fsanzeni/Body-Moulded-Haptic-Compass/3D Modelling/Tests/Combined v1.obj

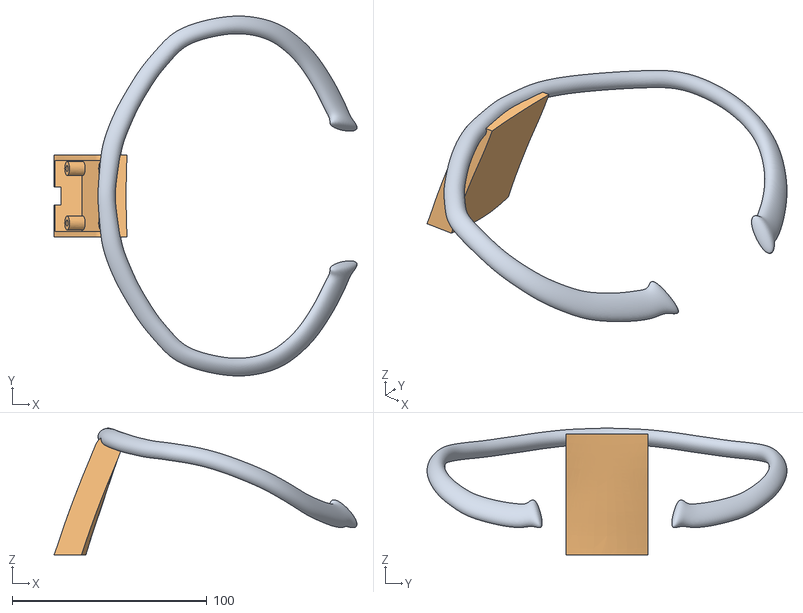
[picture p2: CAD file, 2023-04-23]
3D Modelling/Tests/Combined v1.obj
155.6 x 184.9 x 65.1
