fsanzeni/Body-Moulded-Haptic-Compass/PCB Design/NanoBLE_Compass/NanoBLE_Compass.step

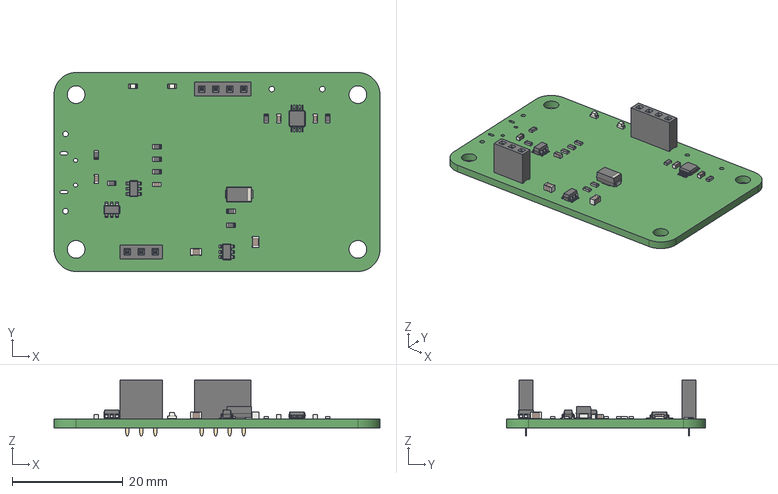
[picture p3: CAD file, 2023-04-23]
PCB Design/NanoBLE_Compass/NanoBLE_Compass.step
59.0 x 36.0 x 10.1 mm
