fsanzeni/Body-Moulded-Haptic-Compass/3D Modelling/Tests/Test_1 v1.stl

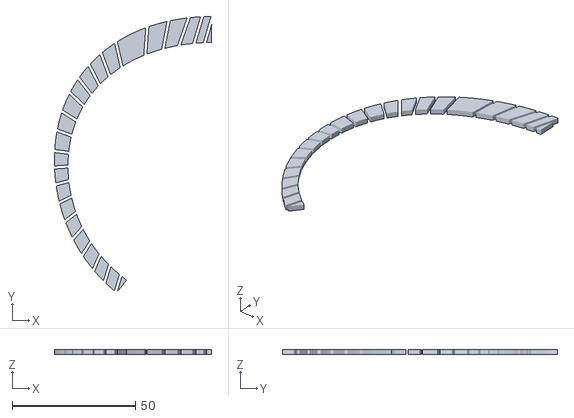
[picture p4: CAD file, 2023-04-23]
3D Modelling/Tests/Test_1 v1.stl
63.7 x 111.4 x 2.00
