fsanzeni/Body-Moulded-Haptic-Compass/3D Modelling/Tests/wearabletest.stl

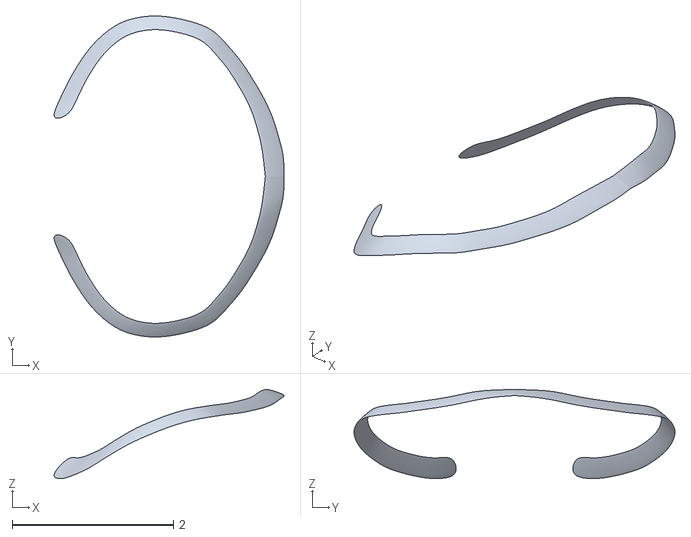
[picture p5: CAD file, 2023-04-23]
3D Modelling/Tests/wearabletest.stl
2.85 x 3.99 x 1.11
