fsanzeni/Body-Moulded-Haptic-Compass/Documentation/Calibration Values.txt

// Gyro
OFFSET MISSING

//Accel scale 16457.0
float B[3]
 {   -0.67,    0.11,   -0.01};

 float Ainv[3][3]
  {{  1.04251,  0.06266,  0.00031},
  {  0.06266,  0.98838, -0.02706},
  {  0.00031, -0.02706,  1.09352}};

// Magnetometer
//Mag scale 3746.0
 float B[3]
 {   24.50,   -2.05,  -47.08};

 float Ainv[3][3]
  {{  2.15592,  0.07699, -0.00474},
  {  0.07699,  2.16073, -0.01097},
  { -0.00474, -0.01097,  2.30156}};
