fsanzeni/Body-Moulded-Haptic-Compass/Documentation/Drift Measurements/raw_acc.xlsx

Time (ms) | Acc_X | Acc_Y | Acc_Z | Mag_X | Mag_Y | Mag_Z | Standard Deviation Acc | Standard Deviation Mag
0 | -0.77 | 0.44 | 1.15 | 40.99 | -18.32 | -54.25 | 0.6846524186 | 14.37910807
104 | 0.19 | 1.14 | -0.11 | 31.93 | -23.65 | -55.29
208 | -0.41 | 0.87 | -0.08 | 10.21 | -17.98 | -56.56
312 | -0.87 | -0.34 | -0.55 | 3.82 | -9.4 | -38.95
416 | -0.22 | -0.29 | -0.99 | 12.16 | 9.59 | -30.76
520 | 0.58 | 0.01 | -0.58 | 36.9 | 11.13 | -34.9
624 | 0.34 | 0.71 | 0.07 | 46.75 | -3.17 | -43.55
728 | -0.05 | -0.95 | 0.33 | 34.89 | 14.75 | -35.61
832 | -1.26 | -1.58 | -1.04 | 25.59 | -19.26 | -31.51
936 | -1.71 | 1.01 | -0.15 | 15.38 | -23.1 | -44.36
1040 | -0.81 | -0.84 | 0.57 | 1.71 | 1.43 | -55.04
1144 | 0.26 | -0.79 | -0.05 | 18.43 | 20.37 | -52.44
1248 | 0.92 | 0.51 | -0.61 | 44.17 | 10.35 | -44.25
1352 | 0.3 | 1.3 | -0.05 | 46.79 | -7.82 | -45.46
1456 | -0.63 | 0.52 | 1.34 | 43.47 | -6.35 | -58.92
1560 | -0.24 | 0.53 | 0.51 | 26.98 | -23.69 | -55.27
1664 | 0.3 | 1.26 | 0.66 | 17.76 | -13.7 | -64.98
1768 | 0.26 | 0.28 | 0.78 | 19.92 | -14.59 | -65.81
1872 | -0.2 | 1.17 | 0.83 | 17.82 | -7.36 | -70.39
1976 | 0.31 | 0.84 | 0 | 43.58 | -20.76 | -52.6
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
