fsanzeni/Body-Moulded-Haptic-Compass/PCB Design/NanoBLE_Compass/pcb.pdf

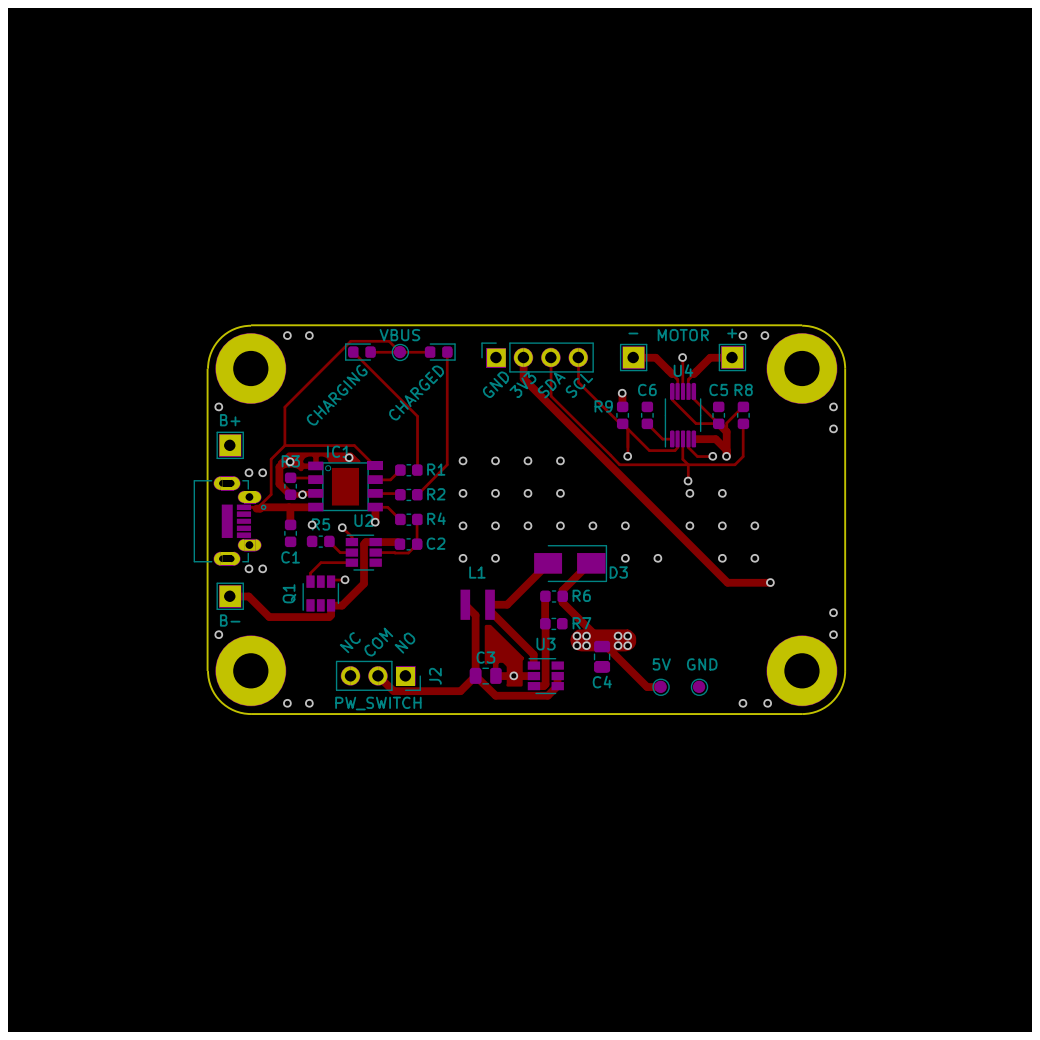
[picture p6: page 1]
