fsanzeni/Body-Moulded-Haptic-Compass/PCB Design/NanoBLE_Compass/pcb2.pdf

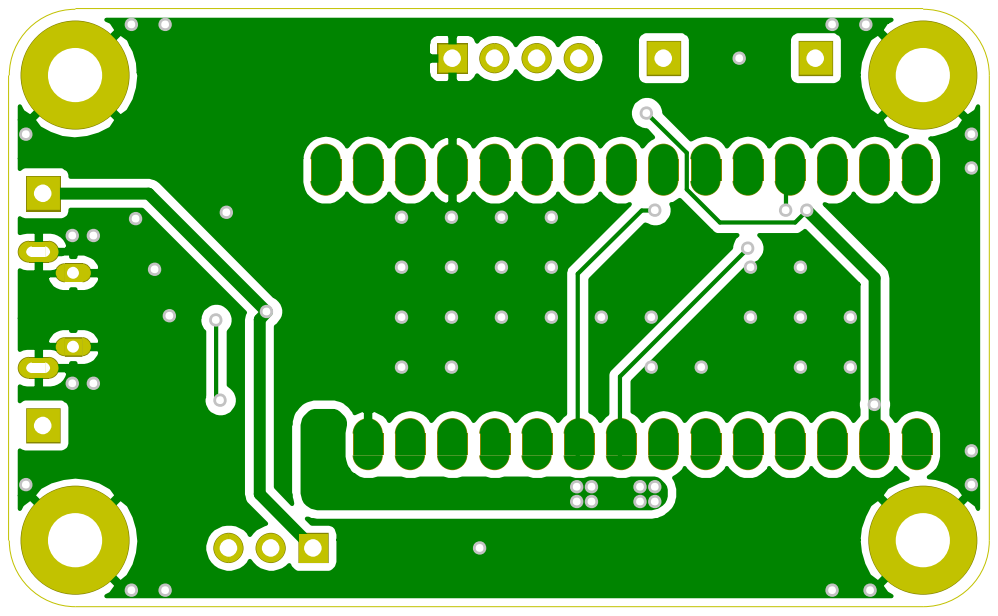
[picture p7: page 1]
