fsanzeni/Body-Moulded-Haptic-Compass/PCB Design/NanoBLE_Compass/schematic.pdf

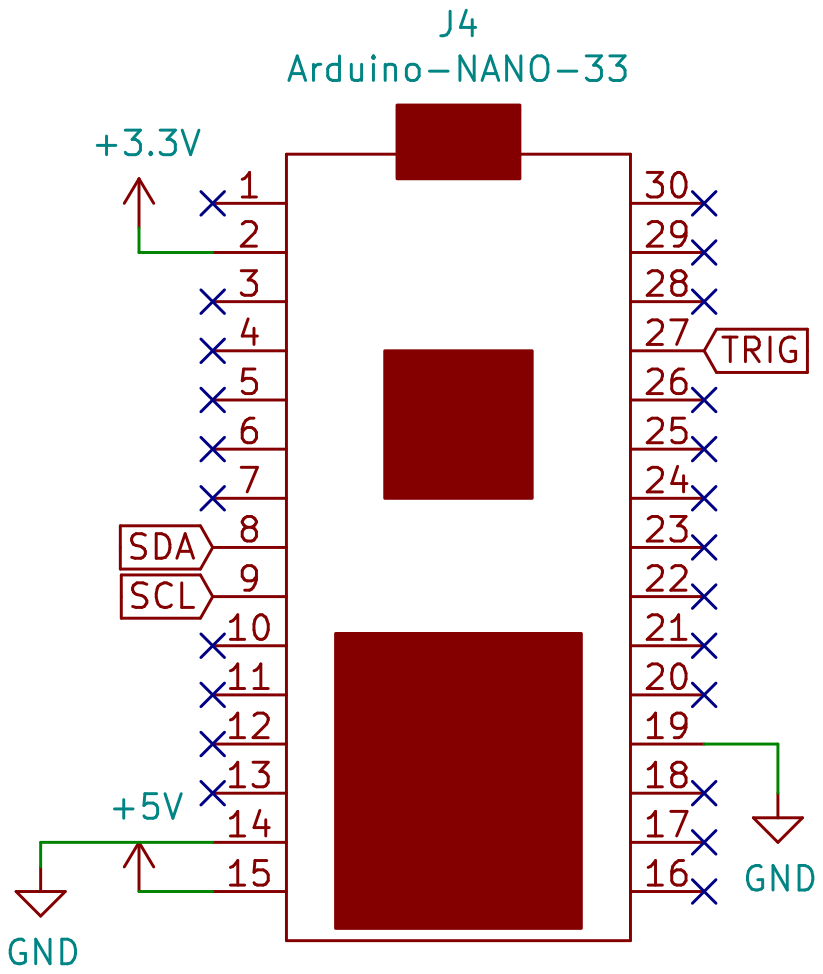
[picture p8: page 1]
