fsanzeni/Body-Moulded-Haptic-Compass/PCB Design/NanoBLE_Compass/NanoBLE_Compass.kicad_pcb

## KiCad design PCB Design/NanoBLE_Compass/NanoBLE_Compass.kicad_pcb (2023-04-23)

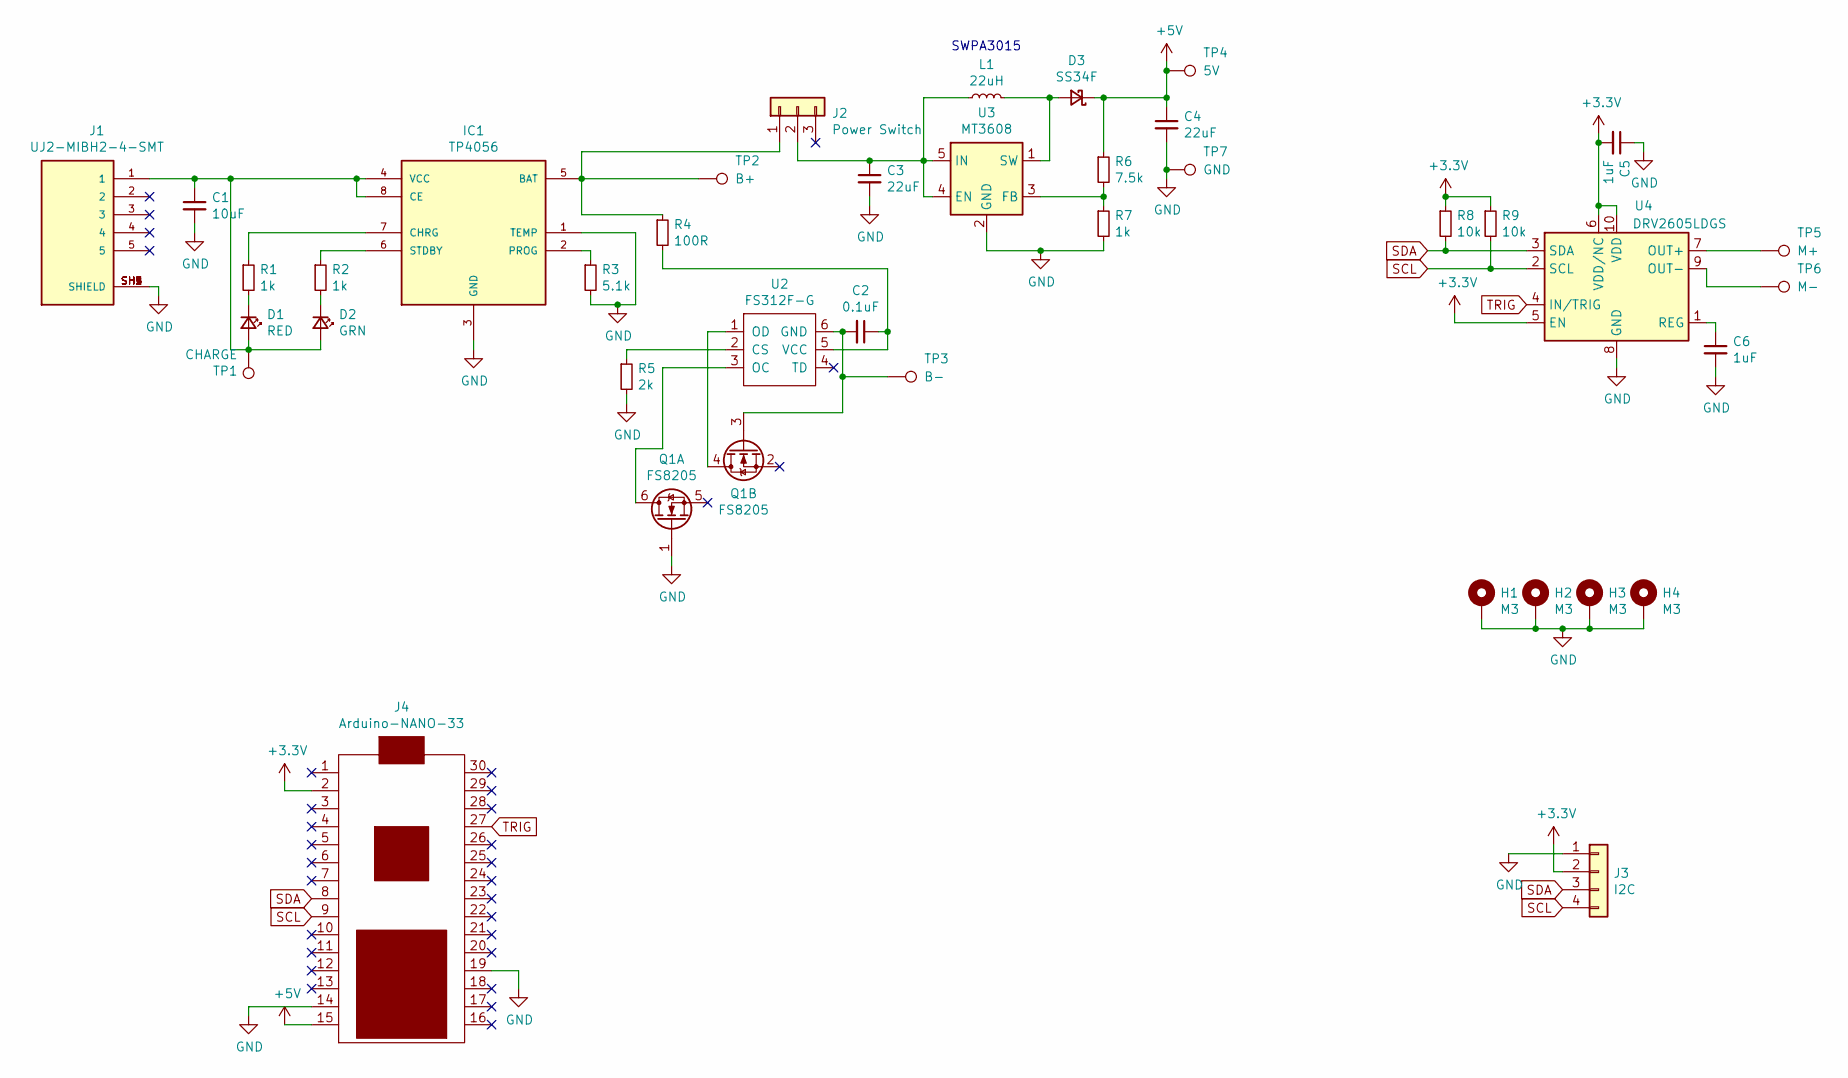
[picture p9: schematic NanoBLE_Compass.sch]

Parts:
C1: 10uF; C_0603_1608Metric
C2: 0.1uF; C_0603_1608Metric
C3, C4: 22uF; C_0805_2012Metric
C5, C6: 1uF; C_0603_1608Metric
D1: RED; LED_0603_1608Metric
D2: GRN; LED_0603_1608Metric
D3: SS34F; D_SMA
H1, H2, H3, H4: M3; MountingHole_3.2mm_M3_Pad
IC1: TP4056; SOP-8
J1: UJ2-MIBH2-4-SMT; CUI_UJ2-MIBH2-4-SMT; PART_REV 1.0
J2: Power Switch; PinSocket_1x03_P2.54mm_Vertical
J3: I2C; PinSocket_1x04_P2.54mm_Vertical
J4: Arduino-NANO-33; nano33_Footprint_SMD_Castell
L1: 22uH; SWPA3015
Q1: FS8205; SOT-23-6
R1, R2, R7: 1k; R_0603_1608Metric
R3: 5.1k; R_0603_1608Metric
R4: 100R; R_0603_1608Metric
R5: 2k; R_0603_1608Metric
R6: 7.5k; R_0603_1608Metric
R8, R9: 10k; R_0603_1608Metric
TP1: CHARGE; TestPoint_Pad_D1.0mm
TP2: B+; TestPoint_THTPad_2.0x2.0mm_Drill1.0mm
TP3: B-; TestPoint_THTPad_2.0x2.0mm_Drill1.0mm
TP4: 5V; TestPoint_Pad_D1.0mm
TP5: M+; TestPoint_THTPad_2.0x2.0mm_Drill1.0mm
TP6: M-; TestPoint_THTPad_2.0x2.0mm_Drill1.0mm
TP7: GND; TestPoint_Pad_D1.0mm
U2: FS312F-G; SOT-23-6
U3: MT3608; SOT-23-6
U4: DRV2605LDGS; VSSOP-10_3x3mm_P0.5mm

Connections:
+3V3: C5.2, J3.2, J4.2, R8.1, R9.1, U4.5 (EN), U4.6 (VDD/NC), U4.10 (VDD)
+5V: C4.1, D3.1 (K), J4.15, R6.1, TP4.1
GND: C1.2, C3.2, C4.2, C5.1, C6.2, H1.1, H2.1, H3.1, H4.1, IC1.1 (TEMP), IC1.3 (GND), J1.SH1 (SHIELD), J1.SH2 (SHIELD), J1.SH3 (SHIELD), J1.SH4 (SHIELD), J1.SH5 (SHIELD), J3.1, J4.14, J4.19, Q1.1 (G), R3.2, R5.2, R7.2, TP7.1, U3.2 (GND), U4.8 (GND)
unnamed: C1.1, D1.2 (A), D2.2 (A), IC1.4 (VCC), IC1.8 (CE), J1.1, TP1.1
unnamed: C2.1, R4.2, U2.5 (VCC)
unnamed: C2.2, Q1.3 (G), TP3.1, U2.6 (GND)
unnamed: C3.1, J2.2, L1.1, U3.4 (EN), U3.5 (IN)
unnamed: C6.1, U4.1 (REG)
unnamed: D1.1 (K), R1.2
unnamed: D2.1 (K), R2.2
unnamed: D3.2 (A), L1.2, U3.1 (SW)
unnamed: IC1.2 (PROG), R3.1
unnamed: IC1.5 (BAT), J2.1, R4.1, TP2.1
unnamed: IC1.6 (STDBY), R2.1
unnamed: IC1.7 (CHRG), R1.1
unnamed: Q1.4 (D), U2.1 (OD)
unnamed: Q1.6 (D), U2.3 (OC)
unnamed: R5.1, U2.2 (CS)
unnamed: R6.2, R7.1, U3.3 (FB)
unnamed: TP5.1, U4.7 (OUT+)
unnamed: TP6.1, U4.9 (OUT-)
SCL: J3.4, J4.9, R9.2, U4.2 (SCL)
SDA: J3.3, J4.8, R8.2, U4.3 (SDA)
TRIG: J4.27, U4.4 (IN/TRIG)

Notes on the sheet:
SWPA3015

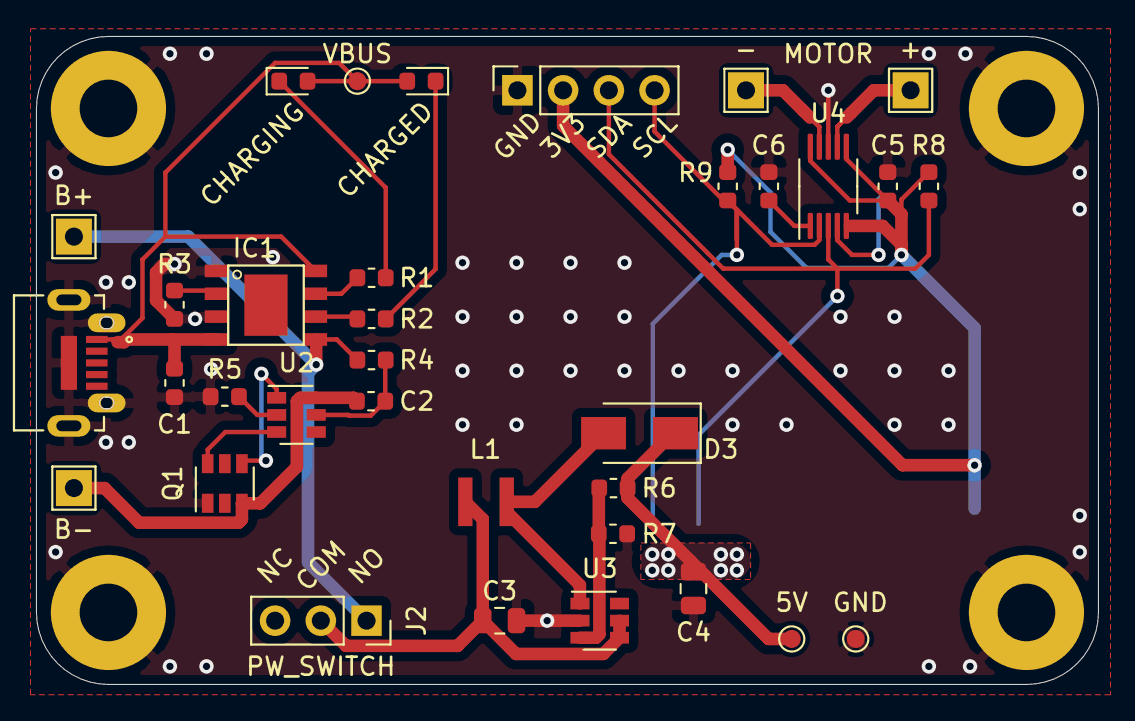
[picture p10: board NanoBLE_Compass.kicad_pcb from above]

Board: 2 copper layers, 59.0 x 36.0 mm, 39 parts (1 on the bottom side), 24 nets.
