fsanzeni/Body-Moulded-Haptic-Compass/Code/BLE/BLE.ino

#include <ArduinoBLE.h>

// Device name
const char* nameOfPeripheral = "Wearable HID";
const char* uuidOfService = "00001812-0000-1000-8000-00805f9b34fb";
const char* uuidOfRxChar = "00002A3D-0000-1000-8000-00805f9b34fb";
const char* uuidOfTxChar = "00002A58-0000-1000-8000-00805f9b34fb";

// BLE Service
BLEService wearableService(uuidOfService);

// Setup the incoming data characteristic (RX).
const int RX_BUFFER_SIZE = 256;
bool RX_BUFFER_FIXED_LENGTH = false;

// RX / TX Characteristics
BLECharacteristic rxChar(uuidOfRxChar, BLEWriteWithoutResponse | BLEWrite, RX_BUFFER_SIZE, RX_BUFFER_FIXED_LENGTH);
BLEByteCharacteristic txChar(uuidOfTxChar, BLERead | BLENotify | BLEBroadcast);

void setup() {
  // Start serial.
  Serial.begin(9600);

  // Ensure serial port is ready.
  while (!Serial);

  // Prepare LED pins.
  pinMode(LED_BUILTIN, OUTPUT);
  pinMode(LEDR, OUTPUT);
  pinMode(LEDG, OUTPUT);

  // Start BLE.
  startBLE();

  // Create BLE service and characteristics.
  BLE.setLocalName(nameOfPeripheral);
  BLE.setAdvertisedService(wearableService);
  wearableService.addCharacteristic(rxChar);
  wearableService.addCharacteristic(txChar);
  BLE.addService(wearableService);

  // Bluetooth LE connection handlers.
  BLE.setEventHandler(BLEConnected, onBLEConnected);
  BLE.setEventHandler(BLEDisconnected, onBLEDisconnected);

  // Event driven reads.
  rxChar.setEventHandler(BLEWritten, onRxCharValueUpdate);

  // Let's tell devices about us.
  BLE.advertise();

  // Print out full UUID and MAC address.
  Serial.println("Peripheral advertising info: ");
  Serial.print("Name: ");
  Serial.println(nameOfPeripheral);
  Serial.print("MAC: ");
  Serial.println(BLE.address());
  Serial.print("Service UUID: ");
  Serial.println(wearableService.uuid());
  Serial.print("rxCharacteristic UUID: ");
  Serial.println(uuidOfRxChar);
  Serial.print("txCharacteristics UUID: ");
  Serial.println(uuidOfTxChar);


  Serial.println("Bluetooth device active, waiting for connections...");
}

void loop() {
  BLEDevice central = BLE.central();

  if (central)
  {
    // Only send data if we are connected to a central device.
    while (central.connected()) {
      connectedLight();
    }
    disconnectedLight();
  } else {
    disconnectedLight();
  }
}
