fsanzeni/Body-Moulded-Haptic-Compass/Code/Combined/hapticMotor.ino

bool playSingleWaveform(int effectNumber, int coolDown) {
  unsigned long time_now = 0;
  time_now = millis();

  // set the effect to play
  drv.setWaveform(0, effectNumber);                                         // play effect
  drv.setWaveform(1, 0);                                                    // end waveform

  // play the effect
  drv.go();
  Serial.println("Playing effect");

  while (millis() < time_now + coolDown) {
    // wait for cooldown period
  }

  return true;
}

void playTwoWaveforms(int firstEffect, int secondEffect, int coolDown) {
  unsigned long time_now = 0;
  time_now = millis();

  // set the effect to play
  drv.setWaveform(0, firstEffect);                                          // first haptic pattern
  drv.setWaveform(1, secondEffect);                                                    // second haptic pattern
  drv.setWaveform(2, 0);                                                    // end of waveforms

  // play effect
  drv.go();

  while (millis() < time_now + coolDown) {
    // wait for cooldown period
  }
}

int selectWaveform(int effect) {
  switch (effect) {
    case 1:
      Serial.println(F("1 − Strong Click - 100%"));
      return effect;
      break;

    case 2:
      Serial.println(F("2 − Strong Click - 60%"));
      return effect;
      break;

    case 3:
      Serial.println(F("3 − Strong Click - 30%"));
      return effect;
      break;

    case 4:
      Serial.println(F("4 − Sharp Click - 100%"));
      return effect;
      break;

    case 5:
      Serial.println(F("5 − Sharp Click - 60%"));
      return effect;
      break;

    case 6:
      Serial.println(F("6 − Sharp Click - 30%"));
      return effect;
      break;

    case 7:
      Serial.println(F("7 − Soft Bump - 100%"));
      return effect;
      break;

    case 8:
      Serial.println(F("8 − Soft Bump - 60%"));
      return effect;
      break;

    case 9:
      Serial.println(F("9 − Soft Bump - 30%"));
      return effect;
      break;

    case 10:
      Serial.println(F("10 − Double Click - 100%"));
      return effect;
      break;

    case 11:
      Serial.println(F("11 − Double Click - 60%"));
      return effect;
      break;

    case 12:
      Serial.println(F("12 − Triple Click - 100%"));
      return effect;
      break;

    case 13:
      Serial.println(F("13 − Soft Fuzz - 60%"));
      return effect;
      break;

    case 14:
      Serial.println(F("14 − Strong Buzz - 100%"));
      return effect;
      break;

    case 15:
      Serial.println(F("15 − 750 ms Alert 100%"));
      return effect;
      break;

    case 16:
      Serial.println(F("16 − 1000 ms Alert 100%"));
      return effect;
      break;

    case 17:
      Serial.println(F("17 − Strong Click 1 - 100%"));
      return effect;
      break;

    case 18:
      Serial.println(F("18 − Strong Click 2 - 80%"));
      return effect;
      break;

    case 19:
      Serial.println(F("19 − Strong Click 3 - 60%"));
      return effect;
      break;

    case 20:
      Serial.println(F("20 − Strong Click 4 - 30%"));
      return effect;
      break;

    case 21:
      Serial.println(F("21 − Medium Click 1 - 100%"));
      return effect;
      break;

    case 22:
      Serial.println(F("22 − Medium Click 2 - 80%"));
      return effect;
      break;

    case 23:
      Serial.println(F("23 − Medium Click 3 - 60%"));
      return effect;
      break;

    case 24:
      Serial.println(F("24 − Sharp Tick 1 - 100%"));
      return effect;
      break;

    case 25:
      Serial.println(F("25 − Sharp Tick 2 - 80%"));
      return effect;
      break;

    case 26:
      Serial.println(F("26 − Sharp Tick 3 – 60%"));
      return effect;
      break;

    case 27:
      Serial.println(F("27 − Short Double Click Strong 1 – 100%"));
      return effect;
      break;

    case 28:
      Serial.println(F("28 − Short Double Click Strong 2 – 80%"));
      return effect;
      break;

    case 29:
      Serial.println(F("29 − Short Double Click Strong 3 – 60%"));
      return effect;
      break;

    case 30:
      Serial.println(F("30 − Short Double Click Strong 4 – 30%"));
      return effect;
      break;

    case 31:
      Serial.println(F("31 − Short Double Click Medium 1 – 100%"));
      return effect;
      break;

    case 32:
      Serial.println(F("32 − Short Double Click Medium 2 – 80%"));
      return effect;
      break;

    case 33:
      Serial.println(F("33 − Short Double Click Medium 3 – 60%"));
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
      return effect;
      break;

    case 118:
      Serial.println(F("118 − Long buzz for programmatic stopping – 100%"));
      return effect;
      break;

    case 119:
      Serial.println(F("119 − Smooth Hum 1 (No kick or brake pulse) – 50%"));
      return effect;
      break;

    case 120:
      Serial.println(F("120 − Smooth Hum 2 (No kick or brake pulse) – 40%"));
      return effect;
      break;

    case 121:
      Serial.println(F("121 − Smooth Hum 3 (No kick or brake pulse) – 30%"));
      return effect;
      break;

    case 122:
      Serial.println(F("122 − Smooth Hum 4 (No kick or brake pulse) – 20%"));
      return effect;
      break;

    case 123:
      Serial.println(F("123 − Smooth Hum 5 (No kick or brake pulse) – 10%"));
      return effect;
      break;
  }
  return 0; 
}
