fsanzeni/Body-Moulded-Haptic-Compass/Code/Combined/sensorData.ino

bool getHeading(float limit) {
  // declarations:
  float xAcc, yAcc, zAcc, xGyro, yGyro, zGyro, xMag, yMag, zMag;

  // values for orientation:
  float heading;

  // check if the IMU is ready to read:
  if (IMU.accelerationAvailable() && IMU.gyroscopeAvailable() && IMU.magneticFieldAvailable()) {

    // read accelerometer, gyroscope and magnetometer:
    IMU.readAcceleration(xAcc, yAcc, zAcc);
    IMU.readGyroscope(xGyro, yGyro, zGyro);
    IMU.readMagneticField(xMag, yMag, zMag);

    // update the filter, to compute orientation:
    filter.update(xGyro, yGyro, zGyro, xAcc, yAcc, zAcc, xMag, yMag, zMag);

    // print the heading
    heading = filter.getYaw();
    Serial.println(heading);

    if (heading >= 0 && heading <= limit) {
      return true;
    }

    if (heading < 0 && heading >= -limit) {
      return true;
    }
    return false;
  }
  return false;
}
