fsanzeni/Body-Moulded-Haptic-Compass/Code/BLE/GATT_Profiles.ino

/*
const char *GATT_Profile[] {
  "00001800-0000-1000-8000-00805f9b34fb", //index [0]   --> Generic Access
  "00001801-0000-1000-8000-00805f9b34fb", //index [1]   --> Generic Attribute
  "00001802-0000-1000-8000-00805f9b34fb", //index [2]   --> Immediate Alert
  "00001803-0000-1000-8000-00805f9b34fb", //index [3]   --> Link Loss
  "00001804-0000-1000-8000-00805f9b34fb", //index [4]   --> Tx Power
  "00001805-0000-1000-8000-00805f9b34fb", //index [5]   --> Current Time Service
  "00001806-0000-1000-8000-00805f9b34fb", //index [6]   --> Reference Time Update Service
  "00001807-0000-1000-8000-00805f9b34fb", //index [7]   --> Next DST Change Service
  "00001808-0000-1000-8000-00805f9b34fb", //index [8]   --> Glucose
  "00001809-0000-1000-8000-00805f9b34fb", //index [9]   --> Health Thermometer
  "0000180a-0000-1000-8000-00805f9b34fb", //index [10]  --> Device Information
  "0000180d-0000-1000-8000-00805f9b34fb", //index [11]  --> Heart Rate
  "0000180e-0000-1000-8000-00805f9b34fb", //index [12]  --> Phone Alert Status Service
  "0000180f-0000-1000-8000-00805f9b34fb", //index [13]  --> Battery Service
  "00001810-0000-1000-8000-00805f9b34fb", //index [14]  --> Blood Pressure
  "00001811-0000-1000-8000-00805f9b34fb", //index [15]  --> Alert Notification Service
  "00001812-0000-1000-8000-00805f9b34fb", //index [16]  --> Human Interface Device
  "00001813-0000-1000-8000-00805f9b34fb", //index [17]  --> Scan Parameters
  "00001814-0000-1000-8000-00805f9b34fb", //index [18]  --> Running Speed and Cadence
  "00001815-0000-1000-8000-00805f9b34fb", //index [19]  --> Automation IO
  "00001816-0000-1000-8000-00805f9b34fb", //index [20]  --> Cycling Speed and Cadence
  "00001818-0000-1000-8000-00805f9b34fb", //index [21]  --> Cycling Power
  "00001819-0000-1000-8000-00805f9b34fb", //index [22]  --> Location and Navigation
  "0000181a-0000-1000-8000-00805f9b34fb", //index [23]  --> Environmental Sensing
  "0000181b-0000-1000-8000-00805f9b34fb", //index [24]  --> Body Composition
  "0000181c-0000-1000-8000-00805f9b34fb", //index [25]  --> User Data
  "0000181d-0000-1000-8000-00805f9b34fb", //index [26]  --> Weight Scale
  "0000181e-0000-1000-8000-00805f9b34fb", //index [27]  --> Bond Management Service
  "0000181f-0000-1000-8000-00805f9b34fb", //index [28]  --> Continuous Glucose Monitoring
  "00001820-0000-1000-8000-00805f9b34fb", //index [29]  --> Internet Protocol Support Service
  "00001821-0000-1000-8000-00805f9b34fb", //index [30]  --> Indoor Positioning
  "00001822-0000-1000-8000-00805f9b34fb", //index [31]  --> Pulse Oximeter Service
  "00001823-0000-1000-8000-00805f9b34fb", //index [32]  --> HTTP Proxy
  "00001824-0000-1000-8000-00805f9b34fb", //index [33]  --> Transport Discovery
  "00001825-0000-1000-8000-00805f9b34fb", //index [34]  --> Object Transfer Service
  "00001826-0000-1000-8000-00805f9b34fb", //index [35]  --> Fitness Machine
  "00001827-0000-1000-8000-00805f9b34fb", //index [36]  --> Mesh Provisioning Service
  "00001828-0000-1000-8000-00805f9b34fb", //index [37]  --> Mesh Proxy Service
  "00001829-0000-1000-8000-00805f9b34fb"  //index [38]  --> Reconnection Configuration
};
*/
