fsanzeni/Body-Moulded-Haptic-Compass/Code/BLE/BLE_functions.ino

/*
 *  BLUETOOTH
 */
void startBLE() {
  if (!BLE.begin())
  {
    Serial.println("starting BLE failed!");
    while (1);
  }
}

void onRxCharValueUpdate(BLEDevice central, BLECharacteristic characteristic) {
  // central wrote new value to characteristic, update LED
  Serial.print("Characteristic event, read: ");
  byte tmp[256];
  int dataLength = rxChar.readValue(tmp, 256);

  for(int i = 0; i < dataLength; i++) {
    Serial.print((char)tmp[i]);
  }
  Serial.println();
  Serial.print("Value length = ");
  Serial.println(rxChar.valueLength());
}

void onBLEConnected(BLEDevice central) {
  Serial.print("Connected event, central: ");
  Serial.println(central.address());
  connectedLight();
}

void onBLEDisconnected(BLEDevice central) {
  Serial.print("Disconnected event, central: ");
  Serial.println(central.address());
  disconnectedLight();
}

/*
 * LEDS
 */
void connectedLight() {
  digitalWrite(LEDR, LOW);
  digitalWrite(LEDG, HIGH);
}


void disconnectedLight() {
  digitalWrite(LEDR, HIGH);
  digitalWrite(LEDG, LOW);
}
