fsanzeni/Body-Moulded-Haptic-Compass/Code/MadgwickTest/MadgwickTest.ino

// based off of Tom Igoe's version here : https://itp.nyu.edu/physcomp/lessons/accelerometers-gyros-and-imus-the-basics

#include <Arduino_LSM9DS1.h>
#include "MadgwickAHRS.h"

// initialize a Madgwick filter:
Madgwick filter;
// sensor's sample rate is fixed at 104 Hz:
const float sensorRate = 104.00;

void setup() {
  Serial.begin(9600);
  // attempt to start the IMU:
  if (!IMU.begin()) {
    Serial.println("Failed to initialize IMU");
    // stop here if you can't access the IMU:
    while (true);
  }
  // start the filter to run at the sample rate:
  filter.begin(sensorRate);
}

void loop() {
  // values for acceleration and rotation:
  float xAcc, yAcc, zAcc;
  float xGyro, yGyro, zGyro;
//  float xMag, yMag, zMag;

  // values for orientation:
  float roll, pitch, heading;
  // check if the IMU is ready to read:
  if (IMU.accelerationAvailable() &&
      IMU.gyroscopeAvailable()) {
    // read accelerometer &and gyrometer:
    IMU.readAcceleration(xAcc, yAcc, zAcc);
    IMU.readGyroscope(xGyro, yGyro, zGyro);
//    IMU.readMagneticField(xMag, yMag, zMag);

    // update the filter, which computes orientation:
//    filter.update(xGyro, yGyro, zGyro, xAcc, yAcc, zAcc, xMag, yMag, zMag);
filter.updateIMU(xGyro, yGyro, zGyro, xAcc, yAcc, zAcc);

    // print the heading, pitch and roll
    roll = filter.getRoll();
    pitch = filter.getPitch();
    heading = filter.getYaw() - 1.0;
    Serial.print("Orientation: ");
    Serial.print(heading);
    Serial.print(" ");
    Serial.print(pitch);
    Serial.print(" ");
    Serial.println(roll);
    roll = 0;
    pitch =0;
    heading = 0;
  }
}
