fsanzeni/Body-Moulded-Haptic-Compass/(commit log)

2023-04-23 Initial ccommit
    readme missing - will add after submission
    [Combined v1.obj, NanoBLE_Compass-BOM.csv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]
2023-04-23 Fixed PATH
    [NanoBLE_Compass-BOM.csv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]
