fsanzeni/Body-Moulded-Haptic-Compass/Documentation/Photos/First Prototype.jpg

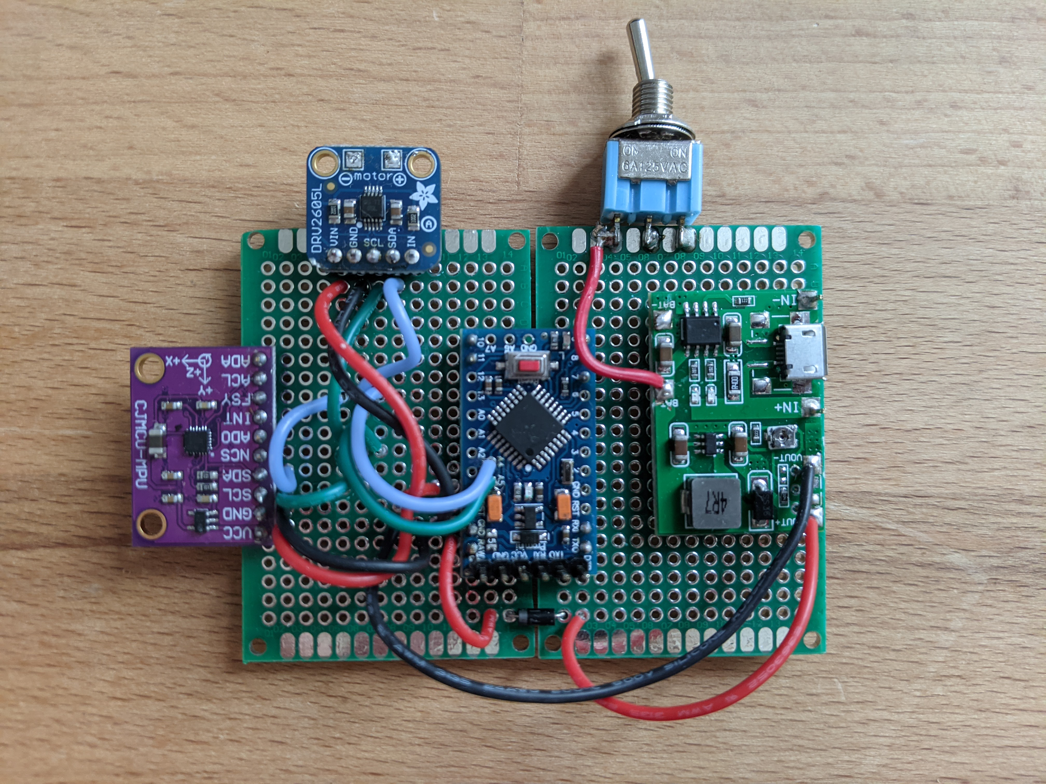
Documentation/Photos/First Prototype.jpg
